CyberGWJ/Home-Assistant/Satellite 1/LD2450 Support/LD2450 Support.step

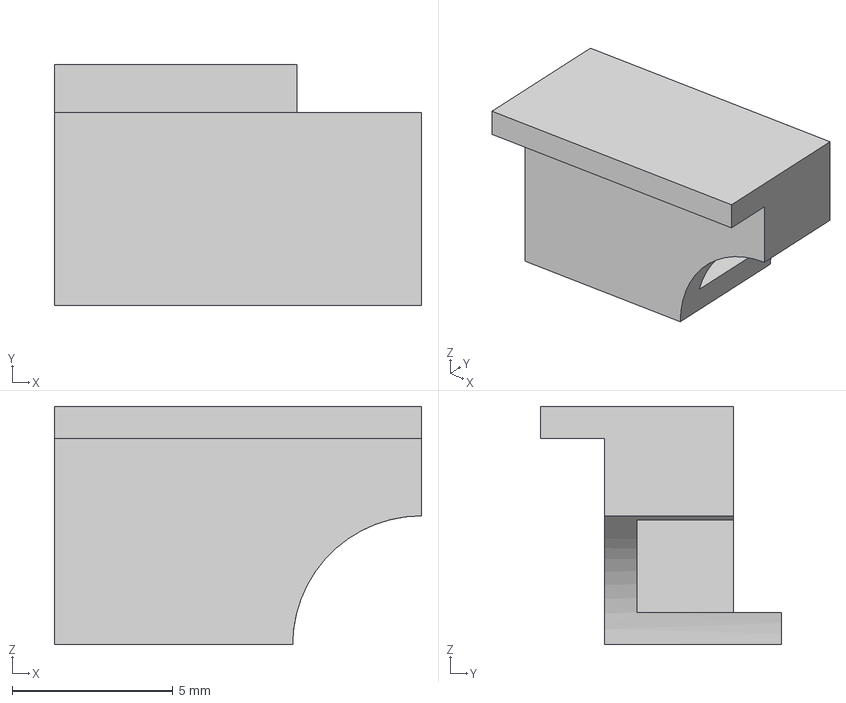
[picture p14: CAD file, 2025-02-05]
Satellite 1/LD2450 Support/LD2450 Support.step
11.4 x 7.50 x 7.40 mm
