CyberGWJ/Home-Assistant/Satellite 1/Modular Chamber Enclosure/EX25VT2-4/mount ring - 2mm.stl

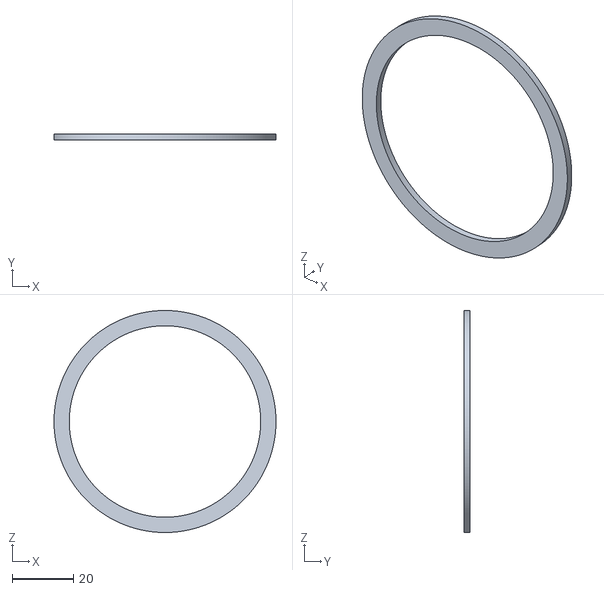
[picture p15: CAD file, 2025-02-26]
Satellite 1/Modular Chamber Enclosure/EX25VT2-4/mount ring - 2mm.stl
72.5 x 2.00 x 72.5
