CyberGWJ/Home-Assistant/Satellite 1/Modular Chamber Enclosure/Version 2/chamber base - TEBM46C-20N.step

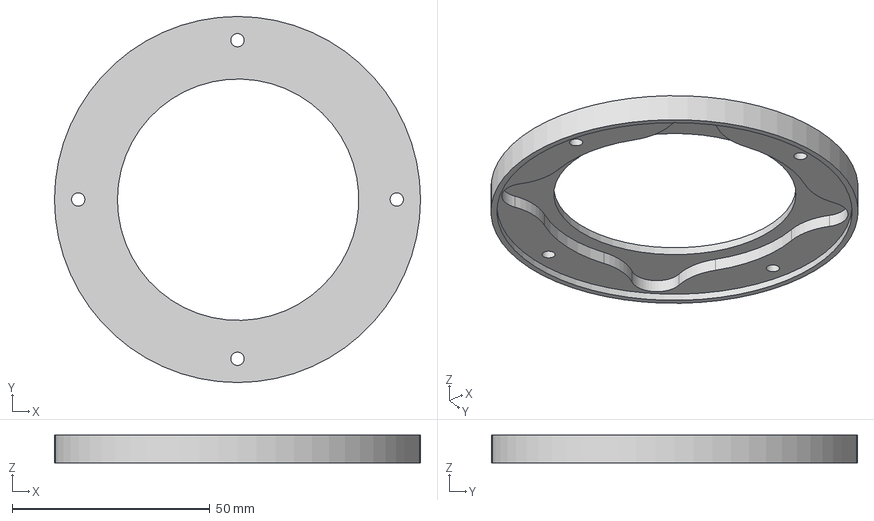
[picture p16: CAD file, 2025-03-11]
Satellite 1/Modular Chamber Enclosure/Version 2/chamber base - TEBM46C-20N.step
92.5 x 92.5 x 7.00 mm
