CyberGWJ/Home-Assistant/Satellite 1/Stand/Sat Stand 2.step

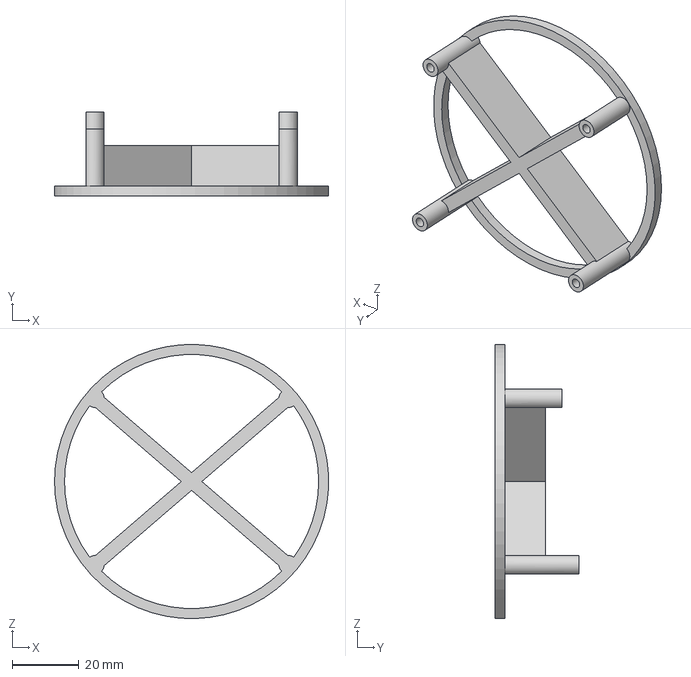
[picture p17: CAD file, 2025-01-24]
Satellite 1/Stand/Sat Stand 2.step
81.9 x 25.0 x 82.0 mm
