CyberGWJ/Home-Assistant/Satellite 1/Modular Chamber Enclosure/EX25VT2-4/EX25VT2-4.stl

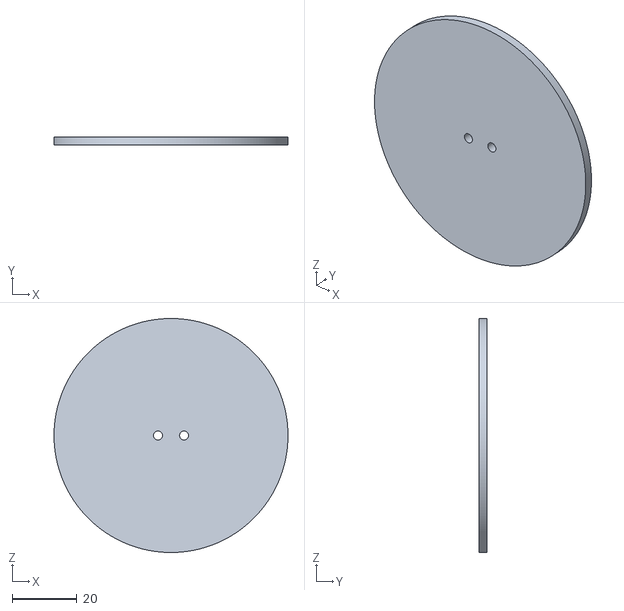
[picture p18: CAD file, 2025-02-26]
Satellite 1/Modular Chamber Enclosure/EX25VT2-4/EX25VT2-4.stl
72.2 x 2.50 x 72.2
