CyberGWJ/Home-Assistant/Satellite 1/Modular Chamber Enclosure/Version 2/wire cap.stl

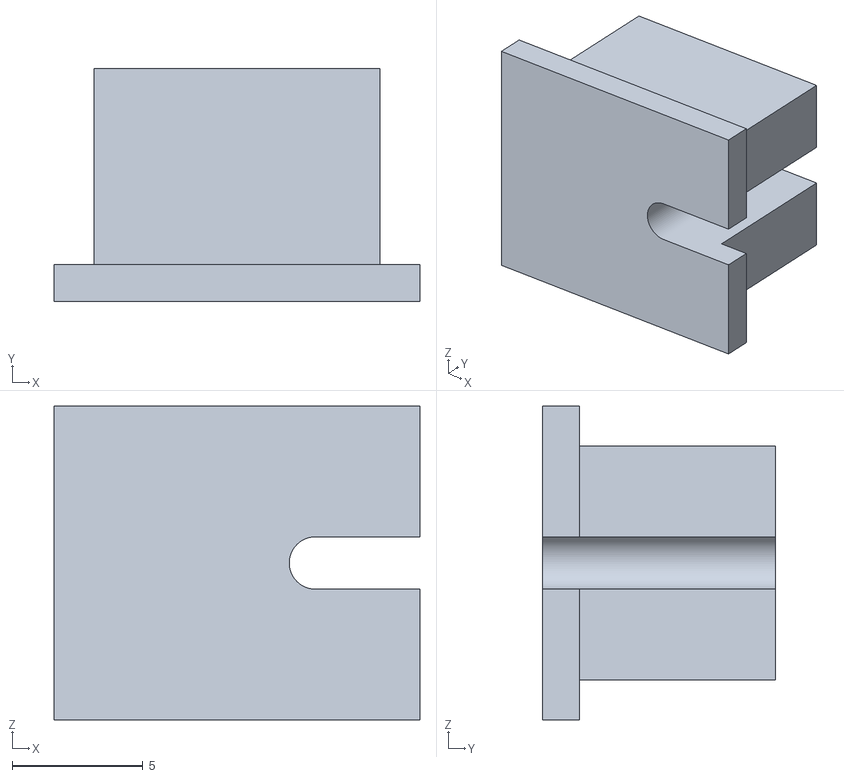
[picture p19: CAD file, 2025-03-07]
Satellite 1/Modular Chamber Enclosure/Version 2/wire cap.stl
14.0 x 8.90 x 12.0
