CyberGWJ/Home-Assistant/Satellite 1/Stand/Sat Stand.step

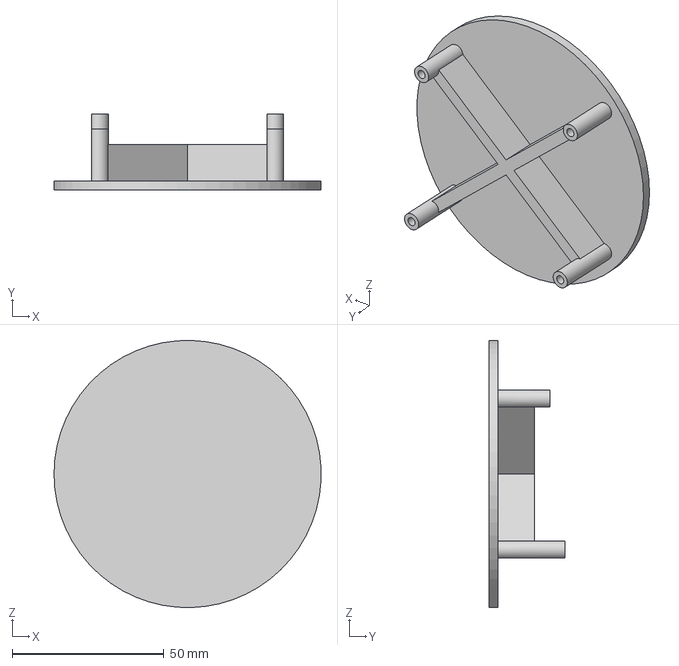
[picture p20: CAD file, 2025-01-24]
Satellite 1/Stand/Sat Stand.step
87.9 x 25.0 x 88.0 mm
