CyberGWJ/Home-Assistant/Satellite 1/Stand/Sat Stand 3.step

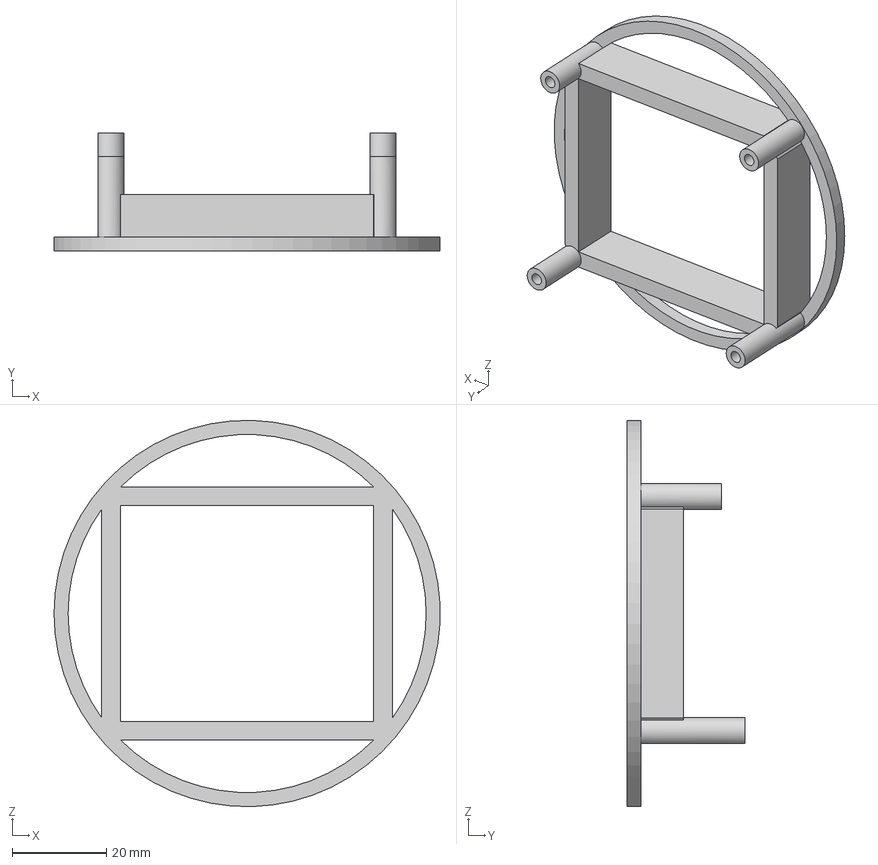
[picture p22: CAD file, 2025-01-24]
Satellite 1/Stand/Sat Stand 3.step
81.9 x 25.0 x 82.0 mm
