CyberGWJ/Home-Assistant/Satellite 1/Modular Chamber Enclosure/Version 2/grommet.step

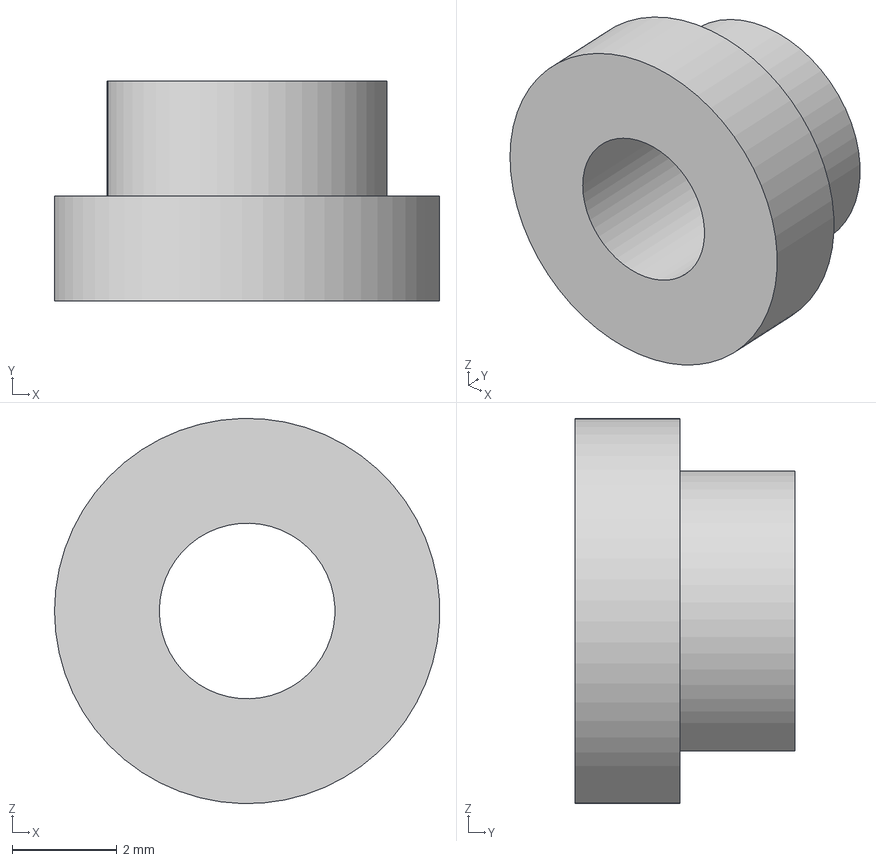
[picture p23: CAD file, 2025-02-26]
Satellite 1/Modular Chamber Enclosure/Version 2/grommet.step
7.34 x 4.20 x 7.35 mm
