CyberGWJ/Home-Assistant/Satellite 1/Modular Chamber Enclosure/Version 2/Bottom TPU Gasket.step

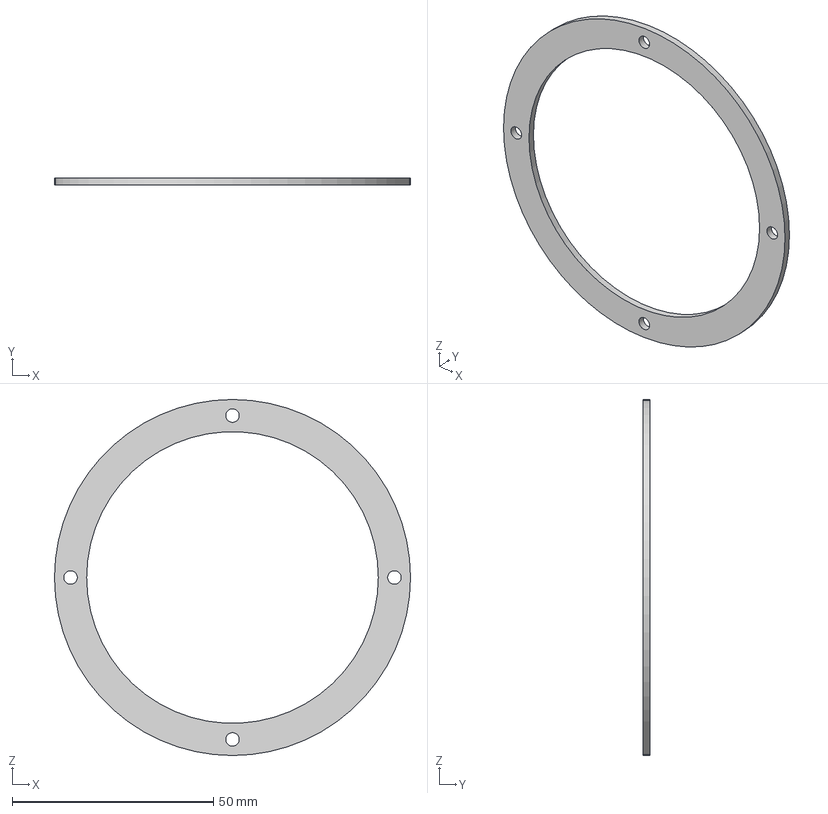
[picture p24: CAD file, 2025-02-26]
Satellite 1/Modular Chamber Enclosure/Version 2/Bottom TPU Gasket.step
88.5 x 1.80 x 88.5 mm
