CyberGWJ/Home-Assistant/Satellite 1/Modular Chamber Enclosure/Version 2/Speaker Stand.step

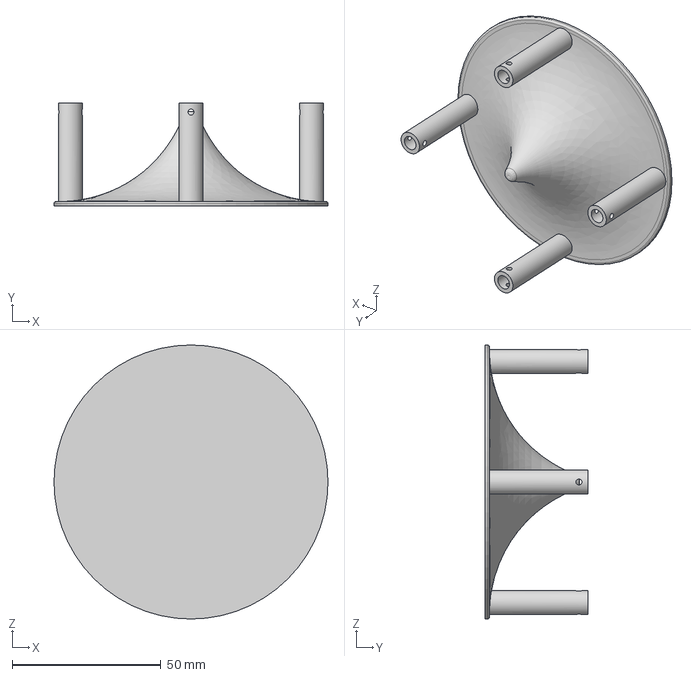
[picture p26: CAD file, 2025-02-26]
Satellite 1/Modular Chamber Enclosure/Version 2/Speaker Stand.step
92.0 x 34.5 x 92.0 mm
