CyberGWJ/Home-Assistant/Satellite 1/Modular Chamber Enclosure/Version 2/stand ring.step

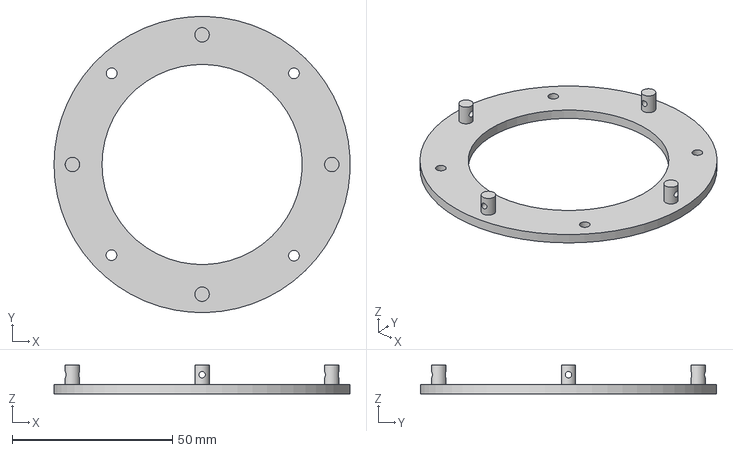
[picture p27: CAD file, 2025-02-26]
Satellite 1/Modular Chamber Enclosure/Version 2/stand ring.step
92.4 x 92.5 x 9.00 mm
