CyberGWJ/Home-Assistant/Satellite 1/Modular Chamber Enclosure/Version 2/chamber top.step

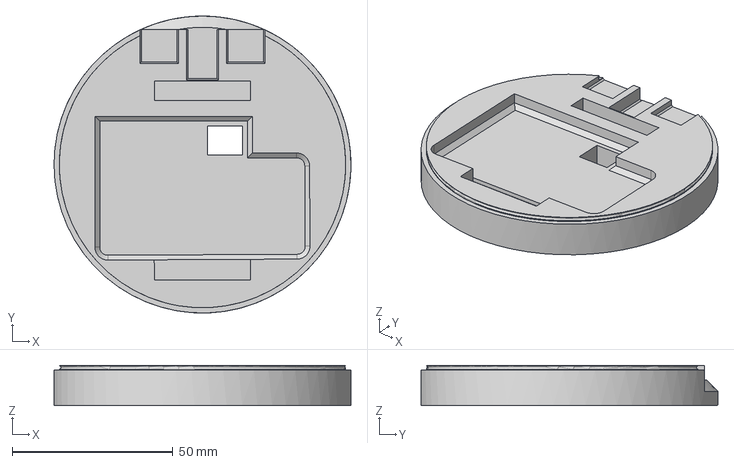
[picture p29: CAD file, 2025-02-26]
Satellite 1/Modular Chamber Enclosure/Version 2/chamber top.step
92.5 x 92.5 x 12.5 mm
