CyberGWJ/Home-Assistant/Satellite 1/Modular Chamber Enclosure/Version 2/chamber body - 30mm.stl

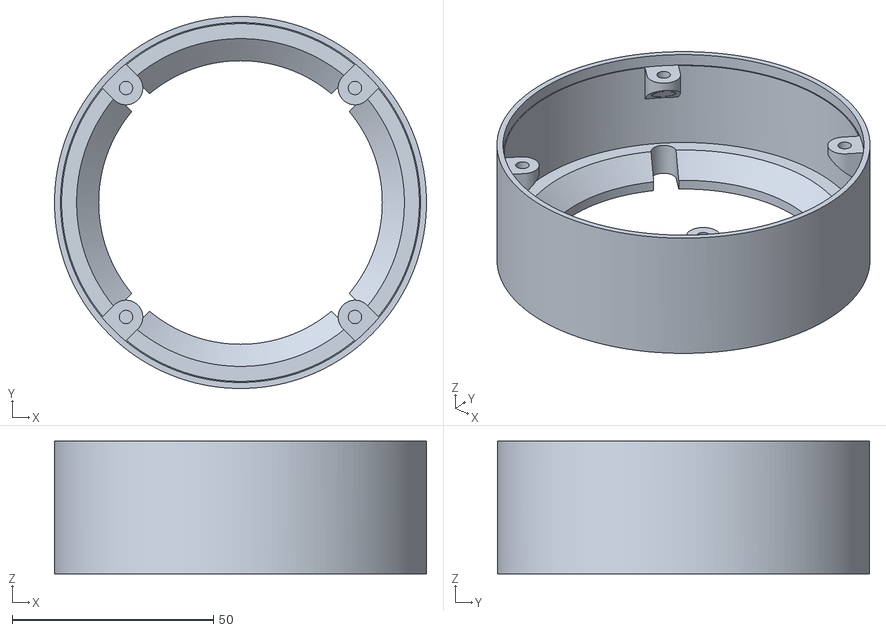
[picture p30: CAD file, 2025-02-26]
Satellite 1/Modular Chamber Enclosure/Version 2/chamber body - 30mm.stl
92.5 x 92.5 x 33.0
