CyberGWJ/Home-Assistant/Satellite 1/Modular Chamber Enclosure/Version 2/chamber body - 45mm.stl

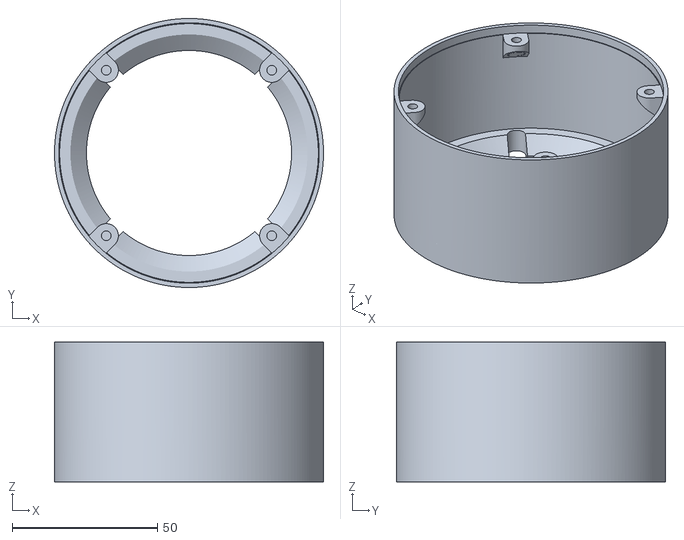
[picture p31: CAD file, 2025-02-26]
Satellite 1/Modular Chamber Enclosure/Version 2/chamber body - 45mm.stl
92.5 x 92.5 x 48.0
