CyberGWJ/Home-Assistant/Satellite 1/Modular Chamber Enclosure/Version 2/Top TPU Buffer.step

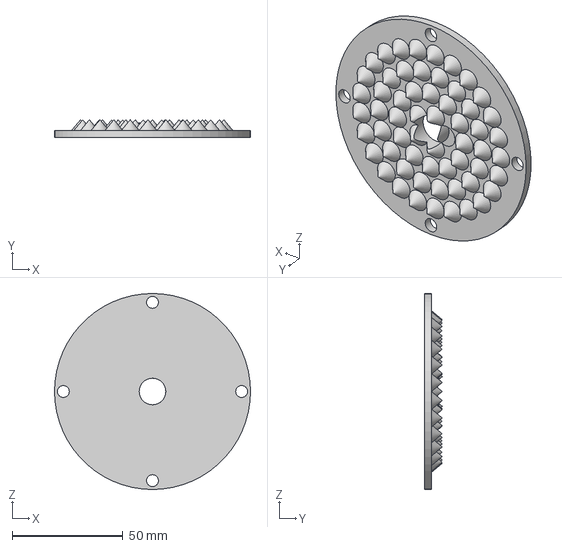
[picture p34: CAD file, 2025-02-26]
Satellite 1/Modular Chamber Enclosure/Version 2/Top TPU Buffer.step
88.5 x 7.92 x 88.5 mm
