CyberGWJ/Home-Assistant/Satellite 1/Modular Chamber Enclosure/Version 2/enclosure-v3.3mf

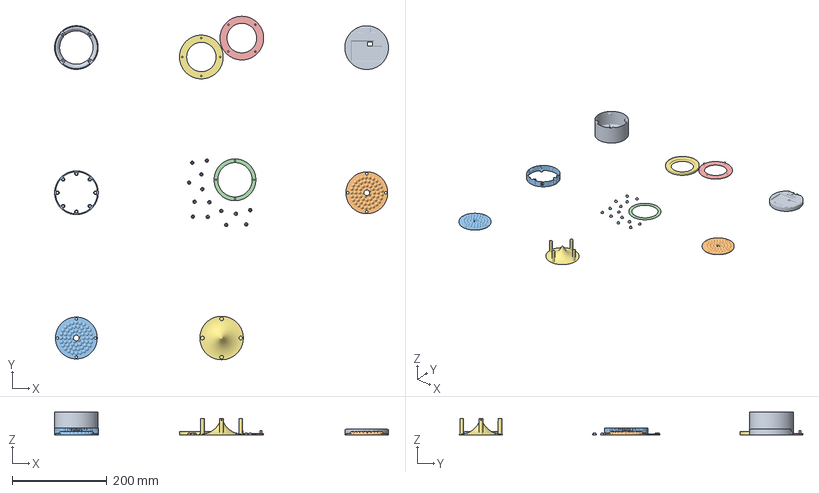
[picture p35: CAD file, 2025-02-26]
Satellite 1/Modular Chamber Enclosure/Version 2/enclosure-v3.3mf
706.5 x 726.6 x 48.0 mm
chamber body.stl
top TPU buffer.stl
top TPU buffer - dome.stl
TPU gasket.stl
stand ring.stl
grommet.stl x 14
chamber base.stl
chamber top.stl
air chamber - 4 - hs.stl
Speaker Stand.stl
