CyberGWJ/Home-Assistant/Satellite 1/Modular Chamber Enclosure/Version 2/air chamber - 4 - hs.stl

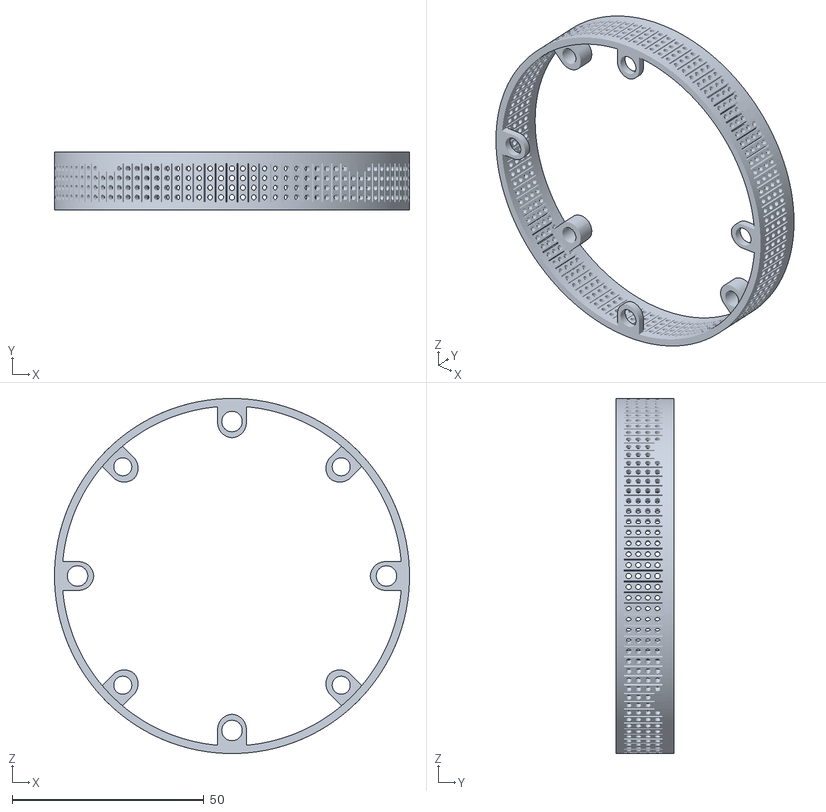
[picture p36: CAD file, 2025-02-26]
Satellite 1/Modular Chamber Enclosure/Version 2/air chamber - 4 - hs.stl
92.5 x 15.0 x 92.5
