CyberGWJ/Home-Assistant/Satellite 1/Modular Chamber Enclosure/Version 2/Top TPU Buffer - dome.step

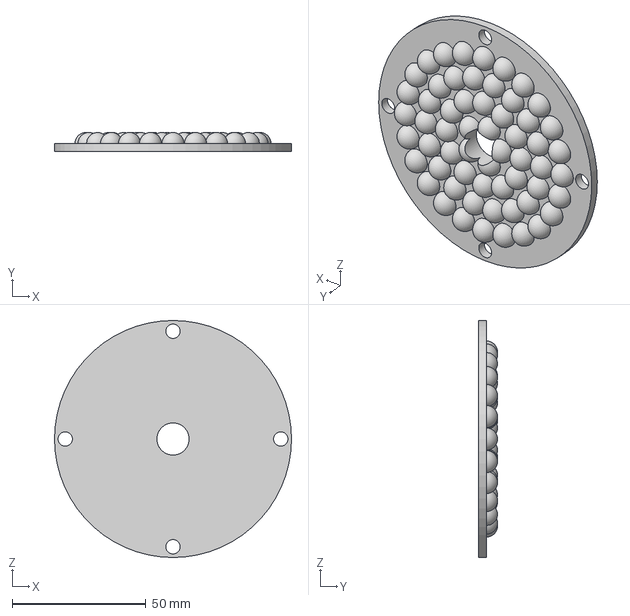
[picture p38: CAD file, 2025-02-26]
Satellite 1/Modular Chamber Enclosure/Version 2/Top TPU Buffer - dome.step
88.5 x 7.12 x 88.5 mm
