CyberGWJ/Home-Assistant/(list of files, cad)

Other CAD files:
Satellite 1/LD2540 Support.step
Satellite 1/Modular Chamber Enclosure/Version 2/chamber base - RS75-4.step
Satellite 1/Modular Chamber Enclosure/Version 2/TPU gasket.stl
Satellite 1/LD2450 Support/LD2450 Support.3mf
Satellite 1/LD2450 Support/LD2450 Support.f3d
Satellite 1/LD2450 Support/LD2450 Support.stl
Satellite 1/Modular Chamber Enclosure/Version 1/DAEX25FHE-4.step
Satellite 1/Modular Chamber Enclosure/Version 1/DAEX25FHE-4.stl
Satellite 1/Modular Chamber Enclosure/Version 1/GRS 3FR-4/GRS 3FR-4 Bottom.stl
Satellite 1/Modular Chamber Enclosure/Version 1/GRS 3FR-4/GRS 3FR-4 Ring.stl
Satellite 1/Modular Chamber Enclosure/Version 1/GRS 3FR-4/GRS 3FR-4 Top.stl
Satellite 1/Modular Chamber Enclosure/Version 1/Speaker Stand.f3d
Satellite 1/Modular Chamber Enclosure/Version 1/Speaker Stand.step
Satellite 1/Modular Chamber Enclosure/Version 1/Speaker Stand.stl
Satellite 1/Modular Chamber Enclosure/Version 1/Stand Lock Ring.step
Satellite 1/Modular Chamber Enclosure/Version 1/Stand Lock Ring.stl
Satellite 1/Modular Chamber Enclosure/Version 1/chamber base.step
Satellite 1/Modular Chamber Enclosure/Version 1/chamber base.stl
Satellite 1/Modular Chamber Enclosure/Version 1/chamber body.f3d
Satellite 1/Modular Chamber Enclosure/Version 1/chamber body.step
Satellite 1/Modular Chamber Enclosure/Version 1/chamber body.stl
Satellite 1/Modular Chamber Enclosure/Version 1/chamber mount ring.step
Satellite 1/Modular Chamber Enclosure/Version 1/chamber mount ring.stl
Satellite 1/Modular Chamber Enclosure/Version 1/chamber top.f3d
Satellite 1/Modular Chamber Enclosure/Version 1/chamber top.step
Satellite 1/Modular Chamber Enclosure/Version 1/chamber top.stl
Satellite 1/Modular Chamber Enclosure/Version 1/wire cap.step
Satellite 1/Modular Chamber Enclosure/Version 1/wire cap.stl
Satellite 1/Modular Chamber Enclosure/Version 2/Speaker Stand.f3d
Satellite 1/Modular Chamber Enclosure/Version 2/Speaker Stand.stl
Satellite 1/Modular Chamber Enclosure/Version 2/chamber base - RS75-4.stl
Satellite 1/Modular Chamber Enclosure/Version 2/chamber base - TEBM46C-20N.stl
Satellite 1/Modular Chamber Enclosure/Version 2/chamber body - holes.f3d
Satellite 1/Modular Chamber Enclosure/Version 2/chamber body - holes.stl
Satellite 1/Modular Chamber Enclosure/Version 2/chamber body.f3d
Satellite 1/Modular Chamber Enclosure/Version 2/chamber top.stl
Satellite 1/Modular Chamber Enclosure/Version 2/grommet.stl
Satellite 1/Modular Chamber Enclosure/Version 2/stand ring.stl
Satellite 1/Modular Chamber Enclosure/Version 2/top TPU buffer.stl
Satellite 1/Stand/Sat Stand 2.3mf
Satellite 1/Stand/Sat Stand 2.f3d
Satellite 1/Stand/Sat Stand 3.3mf
Satellite 1/Stand/Sat Stand 3.f3d
Satellite 1/Stand/Sat Stand.3mf
Satellite 1/Stand/Sat Stand.f3d
Satellite 1/Stand/Sat Stand.stl
Satellite 1/Stand/sat stand 2.stl
Satellite 1/Stand/sat stand 3.stl
