CyberGWJ/Home-Assistant/Satellite 1/Modular Chamber Enclosure/Version 2/Disassembly of enclosure.pdf

# Disassembly of enclosure (Notes at the end)

From bottom to top. Titles are the actual name in F360.
Stand Ring

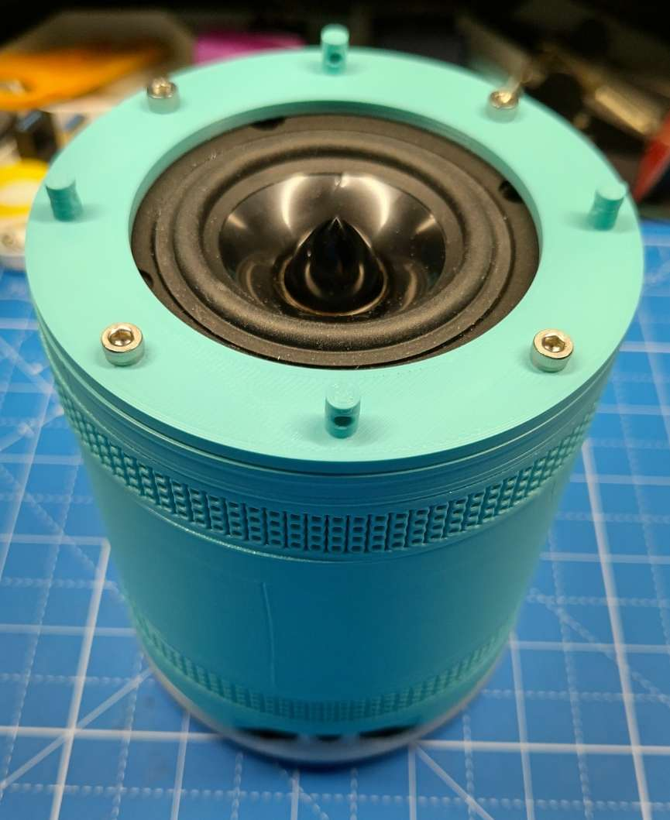
[picture p41: figure]

Bottom TPU Gasket

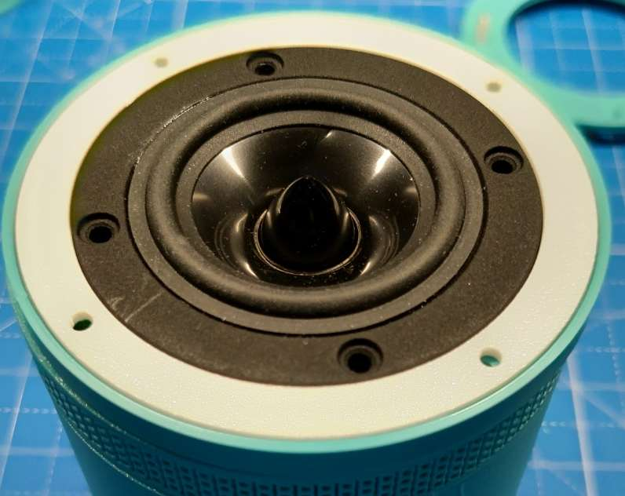
[picture p42: figure]

Chamber Base

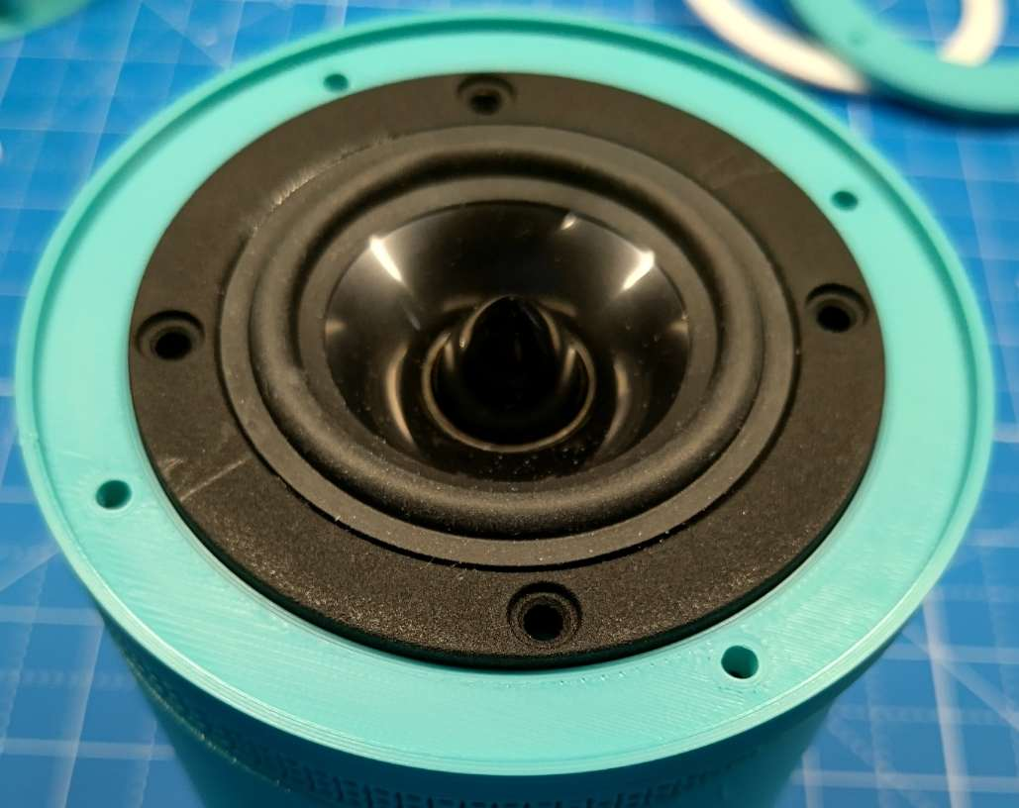
[picture p43: figure]

Air Chamber 4 HS

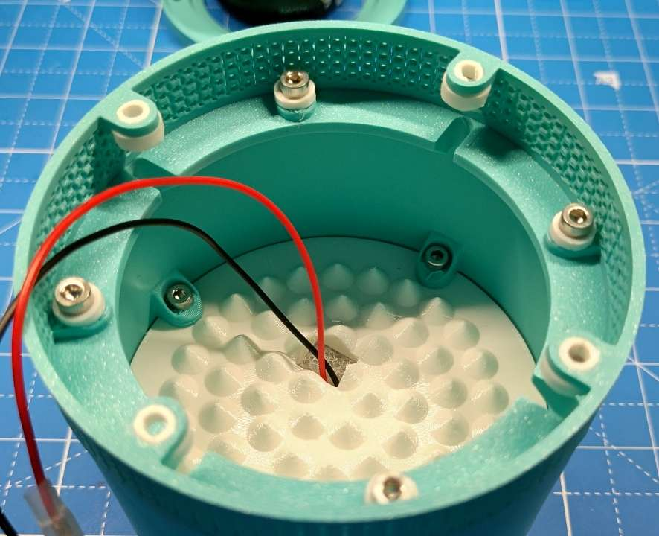
[picture p44: figure]

Chamber Body

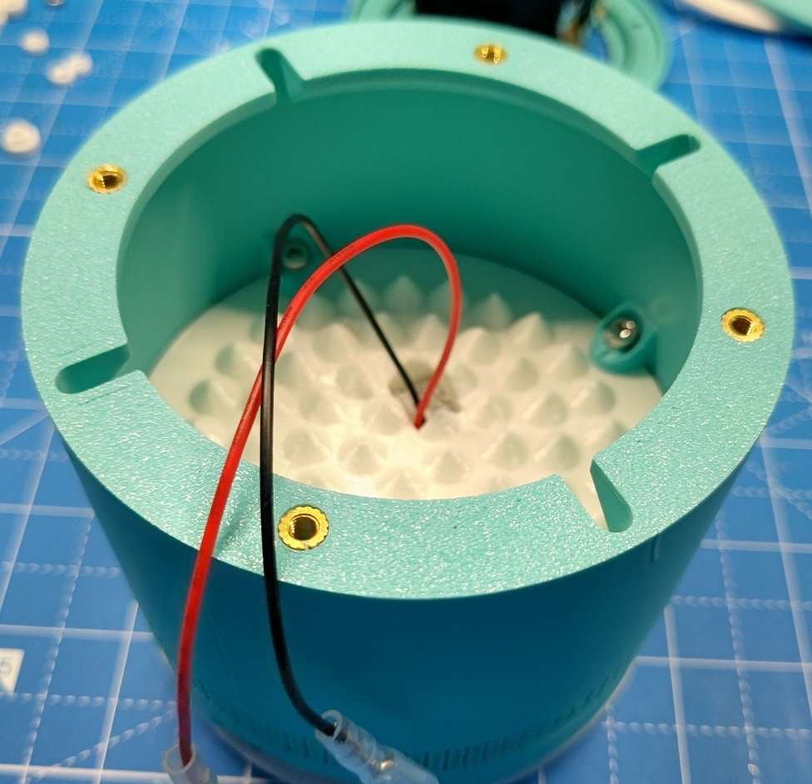
[picture p45: figure]

Top TPU Buer / Top TPU Buer Dome

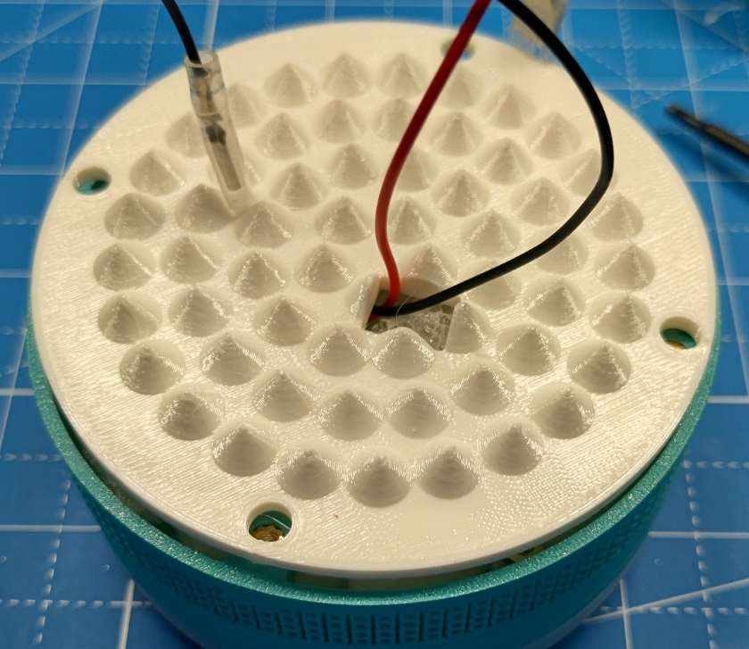
[picture p46: figure]

Foam (used scrapes)

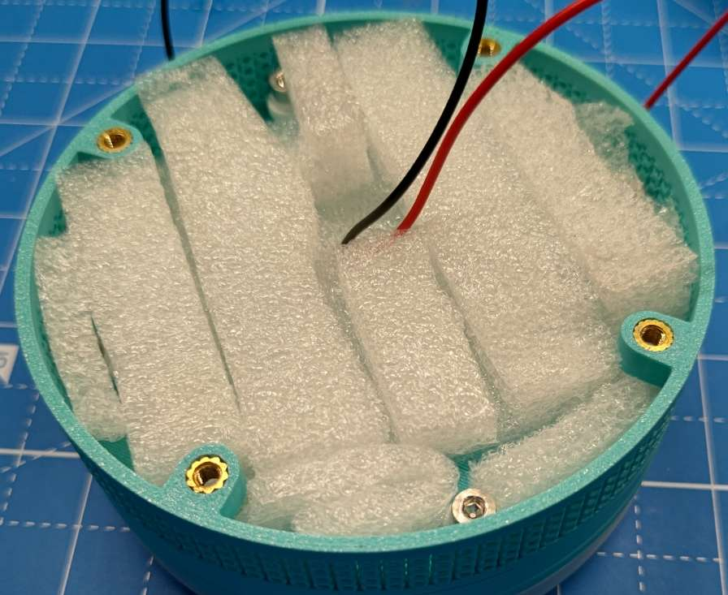
[picture p47: figure]

Air Chamber 4 HS (no shown – repeated) Chamber Top with Grommet

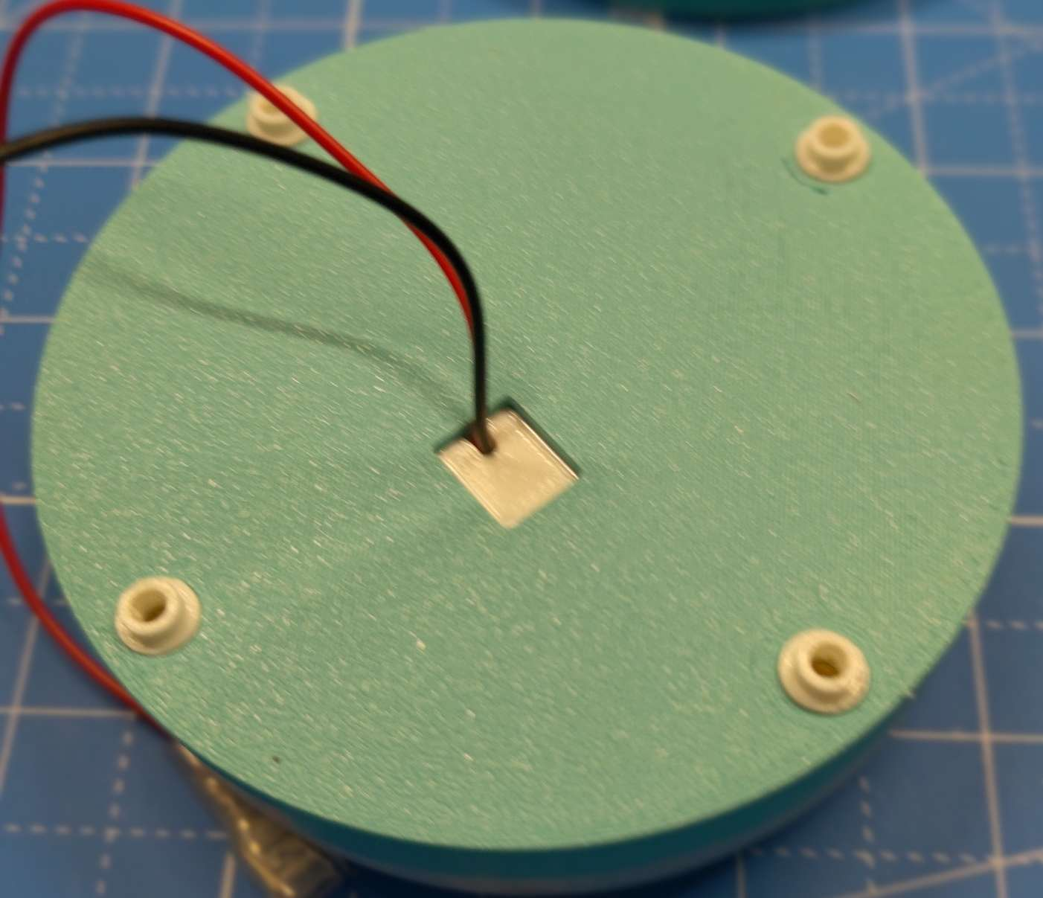
[picture p48: figure]

Chamber Top with Wire Cap (TPU)

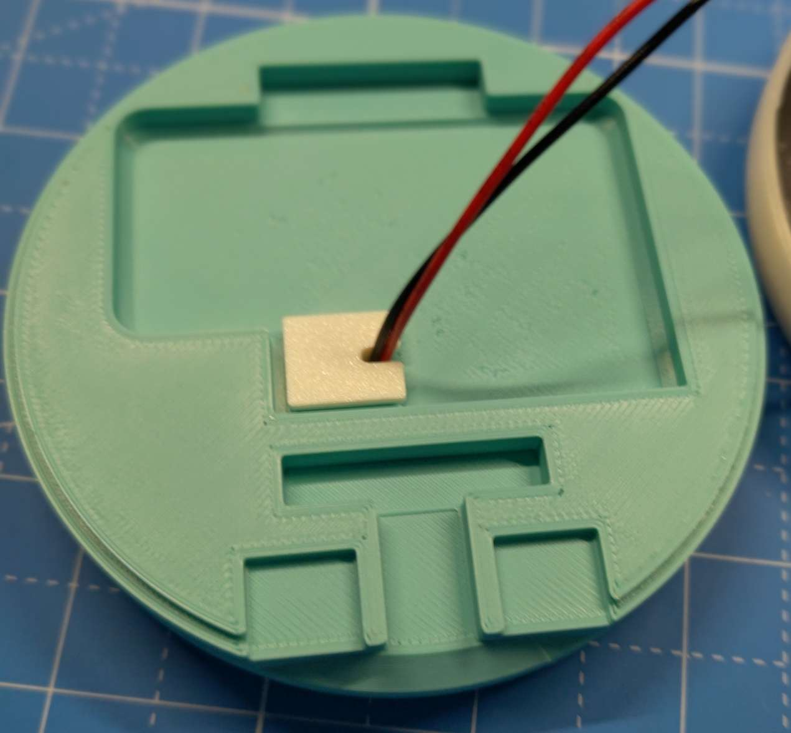
[picture p49: figure]

## Notes

In one chat we had a suspended top that was brought up. So, I decided to use TPU and an Air Chamber with foam to see if that would isolate the sound from the speaker. I still used the TPU Buer. I thought that adding an additional Air Chamber at the bottom of the Chamber Body would help the sound waves escape. The other enclosure parts are like the originals with a few modifications.
One goal was to limit the amount of support required. The heated inserts may not be the best idea, but they work well. These parts are not screwed together tightly. Just enough to hold everything together. TPU grommets were used to give the ridged plastic parts some flexibility.
I am not happy with the Bambu Lab TPU for AMS. It’s too hard compared to regular TPU. I had my two printers busy and did not want to deal with manually printing TPU. It can be a PIA.
Ask a way with any questions. I figure you may have a few.
