CyberGWJ/Home-Assistant/(threads)

Thread 1 (2025-05-14):

GRS 3FR-4 Support

smx, 2025-05-14:
Are you planning on adding parts to support the GRS 3FR-4 in the Satellite 1 version 2 Modular Chamber Enclosure?

CyberGWJ, 2025-05-14:
@smx the new Modular Chamber has the GRS 3FR-4 speaker as an option. You will be good if you have that speaker.

smx, 2025-05-15:
@CyberGWJ thank you for the response. I can't find the chamber base for GRS 3FSR-4 in the [Version 2 folder. ](https://github.com/CyberGWJ/Home-Assistant/tree/main/Satellite%201/Modular%20Chamber%20Enclosure/Version%202)

CyberGWJ, 2025-05-16:
@smx My bad.  I thought you were talking about the version from Future Proof Homes.  Attached is a zip file that contains the STLs for the GRS speaker for my Version 2.

[GRS 3FR-4 (2).zip](https://github.com/user-attachments/files/20257144/GRS.3FR-4.2.zip)

Closed 2025-05-18.
