CyberGWJ/Home-Assistant/(commit log)

2025-01-24 Moved Kwikset Added Satellite 1
    Moved Kwikset files and added Satellite 1 3D files
    [LD2540 Support.3mf, LD2540 Support.f3d, LD2540 Support.step, LD2540 Support.stl, Sat Stand 2.3mf, Sat Stand 2.f3d, Sat Stand 2.step, Sat Stand 3.3mf]
2025-02-05 Reorg files
    Reorg files
    [LD2450 Support.3mf, LD2450 Support.f3d, LD2450 Support.step, LD2450 Support.stl, LD2540 Support.3mf, LD2540 Support.f3d, Sat Stand 2.3mf, Sat Stand 2.f3d]
2025-02-09 Adding modual chamber
    [Speaker Stand.f3d, Speaker Stand.step, Speaker Stand.stl, chamber base.step, chamber base.stl, chamber top.step, chamber top.stl, wire cap.step]
2025-02-09 Updated speaker stand
    [Speaker Stand.f3d, Speaker Stand.step]
2025-02-09 Added missing files
    [Stand Lock Ring.step, Stand Lock Ring.stl]
2025-02-09 Added the DAEX25FHE-4 mount
    This is a test mount for this speaker. Once it is delivered adjustments will made.
    [DAEX25FHE-4.stl]
2025-02-09 Added remaining files
    [DAEX25FHE-4.stl, chamber base.stl, chamber body.f3d, chamber body.step, chamber body.stl, wire cap.stl]
2025-02-09 Update Modular Chamber for Satellite 1.pdf
2025-02-09 Updated body design
    [chamber body.f3d, chamber body.step, chamber body.stl]
2025-02-09 Updated mount ring
    [chamber mount ring.step, chamber mount ring.stl]
2025-02-09 Update chamber mount ring.stl
    [chamber mount ring.stl]
2025-02-09 Finish initial release
    [DAEX25FHE-4.step, DAEX25FHE-4.stl, Speaker Stand.stl]
2025-02-09 Modified directory name
    [DAEX25FHE-4.step, DAEX25FHE-4.stl, Speaker Stand.f3d, Speaker Stand.step, Speaker Stand.stl, Stand Lock Ring.step, Stand Lock Ring.stl, chamber base.step]
2025-02-11 Modified cap
    [chamber top.f3d, chamber top.step]
2025-02-12 Update chamber top.stl
    [chamber top.stl]
2025-02-12 Updated base and lock ring
    Per Brad Davis recommendations these files have benn updated
    [Stand Lock Ring.step, Stand Lock Ring.stl, chamber base.step, chamber base.stl]
2025-02-26 Added Version 2
    Added Version 2and moved Version 1 to its own folder. Documentation to follow.
    [Bottom TPU Gasket.step, DAEX25FHE-4.step, DAEX25FHE-4.stl, Speaker Stand.f3d, Speaker Stand.step, Speaker Stand.stl, Stand Lock Ring.step, Stand Lock Ring.stl]
2025-02-26 Added GRS 3FR-4 and EX25VT2-4 speakers
    Added the GRS 3FR-4 for version 1 and EX25VT2-4 for V1 and V2.
    [EX25VT2-4.stl, GRS 3FR-4 Bottom.stl, GRS 3FR-4 Ring.stl, GRS 3FR-4 Top.stl, mount ring - 2mm.stl]
2025-03-07 Create wire cap.stl
    Added wire cap to version 2
    [wire cap.stl]
2025-03-11 Added TEBM46C-20N speaker
    Added new files for the TEBM46C-20N speaker
    [chamber base - RS75-4.step, chamber base - RS75-4.stl, chamber base - TEBM46C-20N.step, chamber base - TEBM46C-20N.stl]
